4lc0n/TIVA_Oscilloscope/Schematic/Oszilloscope_verbessert/Oszilloscope_verbesserte_Schaltung.pdf

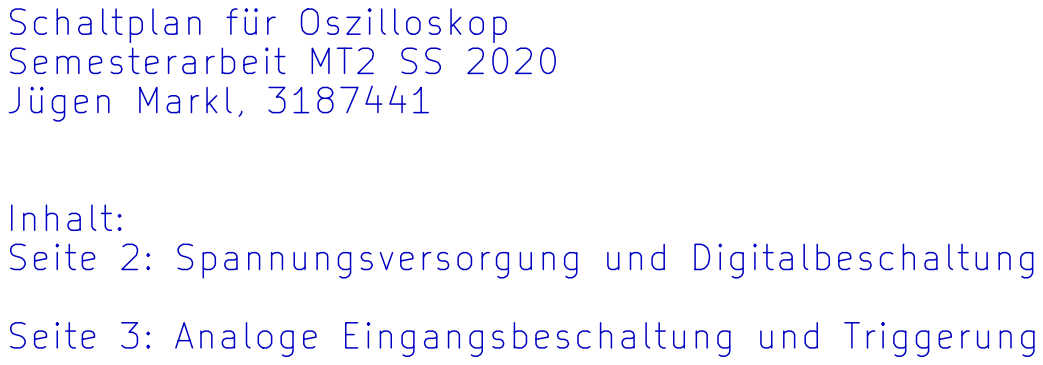
[picture p1: page 1]

File: file5F0DD40D.sch Schaltplan für Oszilloskop

Inhalt:
Seite 2: Spannungsversorgung und Digitalbeschaltung

Seite 3: Analoge Eingangsbeschaltung und Triggerung

File: Oszilloscope.sch Sheet: /
Id: 1/3 Title:

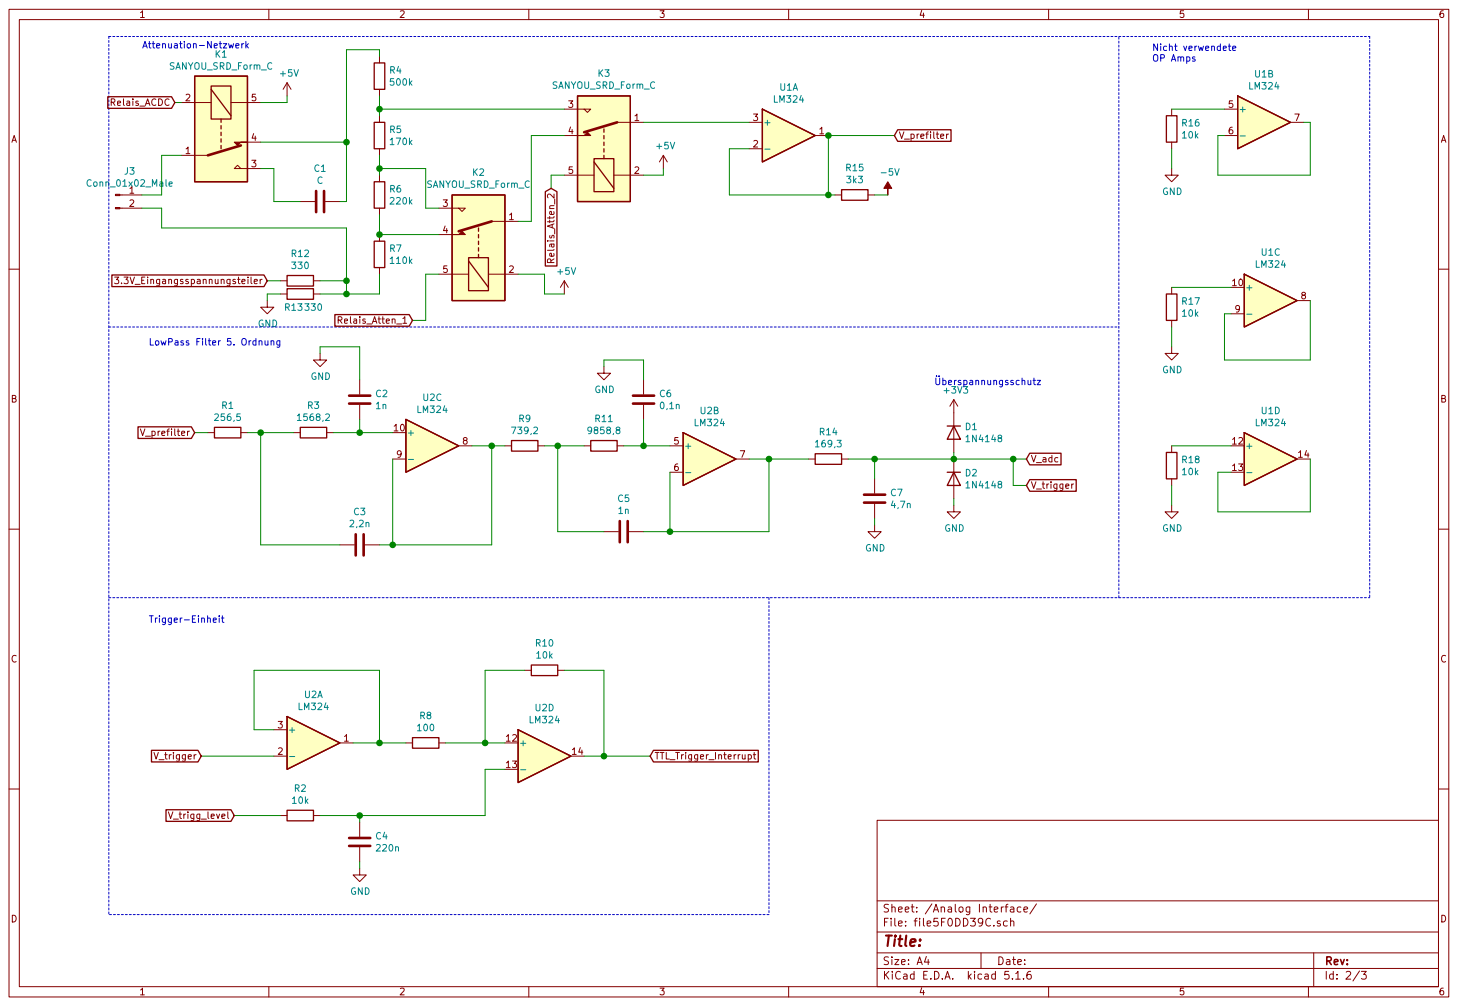
[picture p2: page 2]

Id: 2/3 Title: File: file5F0DD39C.sch Sheet: /Analog Interface/ C4

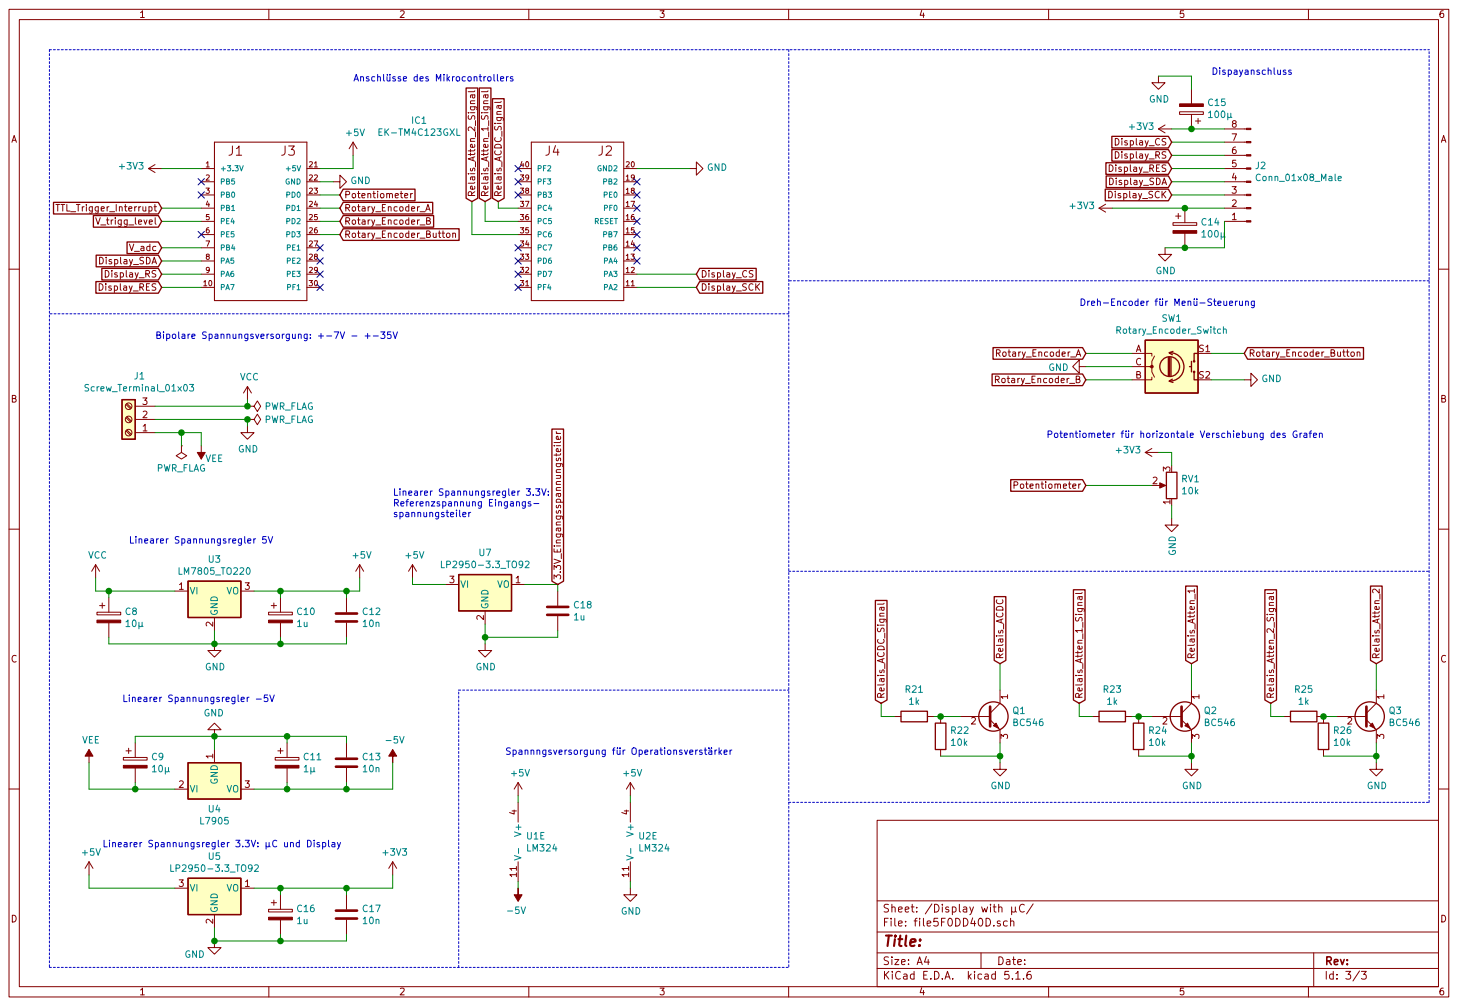
[picture p3: page 3]

Dispayanschluss Anschlüsse des Mikrocontrollers

Dreh-Encoder für Menü-Steuerung

Potentiometer für horizontale Verschiebung des Grafen

Linearer Spannungsregler 3.3V: µC und Display

Id: 3/3 Title: File: file5F0DD40D.sch Sheet: /Display with µC/
