4lc0n/TIVA_Oscilloscope/Source/adc.h

/*
 * adc.h
 *
 *  Created on: May 27, 2020
 *      Author: h2l
 */

#ifndef ADC_H_
#define ADC_H_
#include <stdbool.h>
#include <stdint.h>

//initialize of pins and Interrupts as well as µDMA in Ping Pong Mode
void adc_init();

void adc_prepare();
//void adc_change_averaging(unsigned int nuber_of_averaging);


void ADC0IntHandler(void);
void GPIOBIntHandler(void);

void uDMA_config_primary();
void uDMA_config_secondary();

void adc_init_trigger_gen();
void adc_set_trigger_gen(uint8_t level);

bool sample_user_input();

void set_attenuator(uint8_t divider_setting);
void set_ac_coupling(bool state);

#endif /* ADC_H_ */
