4lc0n/TIVA_Oscilloscope/Source/display.h

/*
 * display.h
 *
 *  Created on: May 26, 2020
 *      Author: h2l
 */

#ifndef SOURCE_DISPLAY_H_
#define SOURCE_DISPLAY_H_

    void display_frame();
    void display_chart();
    void display_update_frame();
    void display_draw_grid();

#endif /* SOURCE_DISPLAY_H_ */
