4lc0n/TIVA_Oscilloscope/Source/helper_fkt.h

/*
 * helper_fkt.h
 *
 *  Created on: May 28, 2020
 *      Author: h2l
 */

#ifndef SOURCE_HELPER_FKT_H_
#define SOURCE_HELPER_FKT_H_

void reverse(char* str, int len);
int intToStr(int x, char str[], int d) ;
void ftoa(float n, char* res, int afterpoint) ;
void strcpy(char *dest, char *src);
#endif /* SOURCE_HELPER_FKT_H_ */
