4lc0n/TIVA_Oscilloscope/(commit log)

2020-05-29 initila commit: basic function to some extend implemented trigger works (with some glitch) display function works (with some glitches) no UI
    [ST7735.obj, adc.obj, display.obj, fifo.obj, helper_fkt.obj, main.obj, timer.obj, tm4c123gh6pm_startup_ccs.obj]
2020-07-05 optimisation cleaner ADC ISR with hardware triggering updates to visualisation added secondary buffer as array for signal processing
    [ST7735.obj, adc.obj, display.obj, fifo.obj, helper_fkt.obj, main.obj, timer.obj, tm4c123gh6pm_startup_ccs.obj]
2020-07-06 1MSample / sec achieved via uDMA
    [ST7735.obj, adc.obj, display.obj, fifo.obj, helper_fkt.obj, main.obj, timer.obj, tm4c123gh6pm_startup_ccs.obj]
2020-07-22 added measurement functions and more menu options
    [ST7735.obj, adc.obj, display.obj, fifo.obj, helper_fkt.obj, main.obj, timer.obj, tm4c123gh6pm_startup_ccs.obj]
2020-07-23 should now be fully functional on hardware board added more display functions linear interpolation prepared, but buggy
    [ST7735.obj, adc.obj, display.obj, fifo.obj, helper_fkt.obj, main.obj, timer.obj, tm4c123gh6pm_startup_ccs.obj]
2020-07-28 added readme
    [ST7735.obj, adc.obj, display.obj, fifo.obj, helper_fkt.obj, main.obj, timer.obj, tm4c123gh6pm_startup_ccs.obj]
2020-07-29 updated README and added Schematic
    [Oszilloscope.kicad_pcb, Oszilloscope.sch, file5F0DD39C.sch, file5F0DD3B4.sch, file5F0DD40D.sch]
2022-05-18 added image of prototype
